mczerski/MysensorsDimmer/README.md

# MysensorsDimmer

Led dimmer board that can be controlled with local switches and remotely witch NRF24L01 RF module. It is based on the Arduino Pro Mini board and is intended to be used with MySensors library.
