mczerski/MysensorsDimmer/descriptions.odt

IN/LED1 | LED2 | LED3

12V GND PWM|12V GND PWM|12V GND PWM

LED4

12V GND PWM

LED5 | SWITCHES | OUT

12V GND PWM|S1 S2 S3 |GND 5V
