mczerski/MysensorsDimmer/MysensorsDimmer.brd

## EAGLE design MysensorsDimmer.brd (2017-07-23)

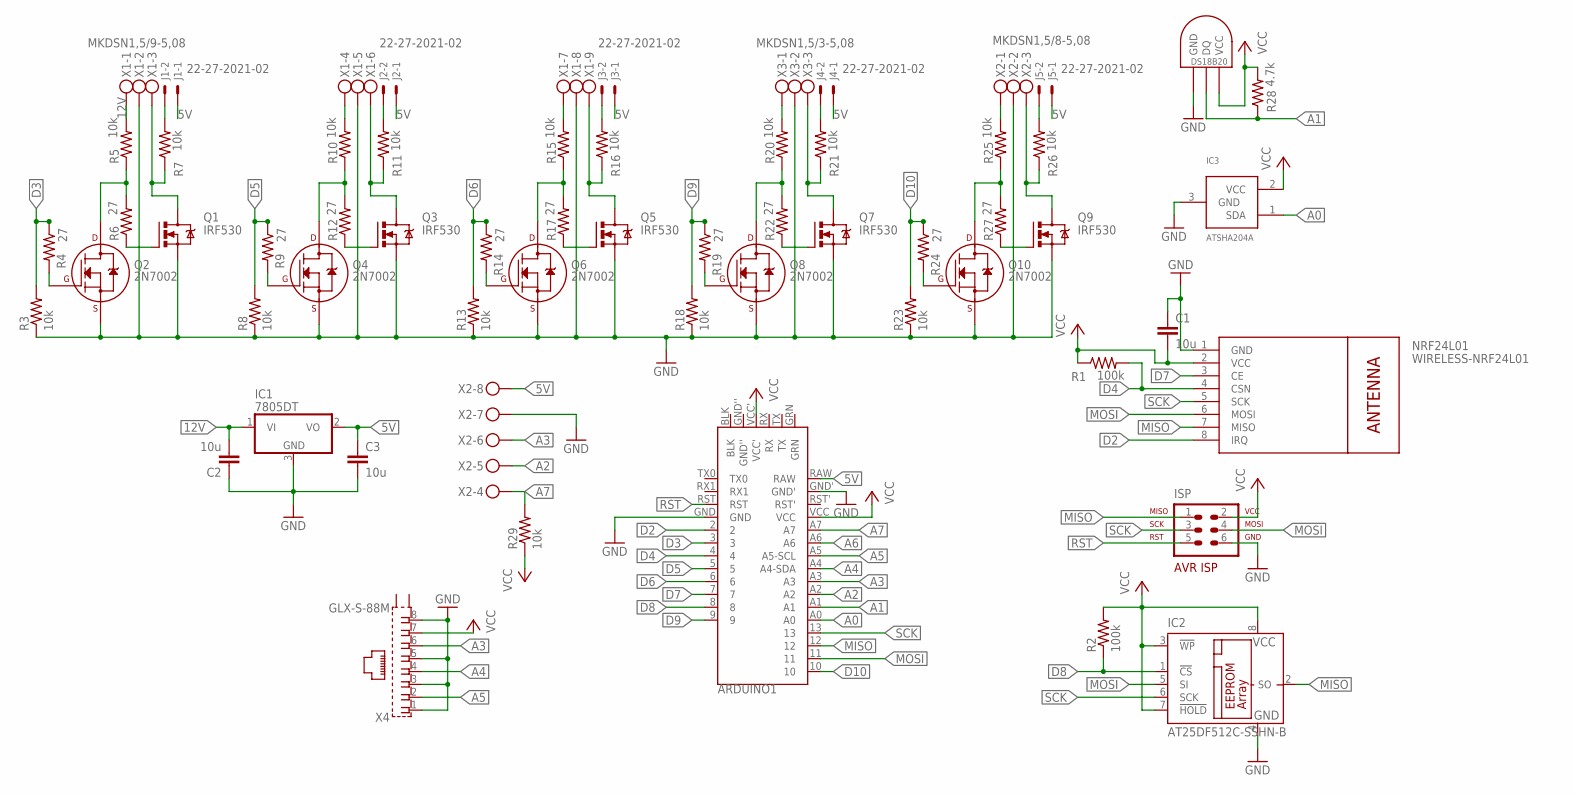
[picture p1: schematic MysensorsDimmer.sch]

Parts:
ARDUINO1: ARDUINO_PRO_MINI_V1
C1, C3: 10u; 0603-CAP
C2: 10u; 1206
IC1: 7805DT; TO252
IC2: AT25DF512C-SSHN-B; SO-08
IC3: ATSHA204A; SOT23
IC4: DS1820; µSOP8
ISP: N/M; AVR-ISP-6
J1, J2, J3, J4, J5: 22-27-2021-02; 6410-02
NRF24L01: WIRELESS-NRF24L01
Q1, Q3, Q5, Q7, Q9: IRF530; TO220BV
Q2, Q4, Q6, Q8, Q10: 2N7002; SOT-23
R1, R2: 100k; 0603-RES
R3, R5, R7, R8, R10, R11, R13, R15, R16, R18, R20, R21, R23, R25, R26, R29: 10k; 0603-RES
R4, R6, R9, R12, R14, R17, R19, R22, R24, R27: 27; 0603-RES
R28: 4.7k; 0603-RES
X1: MKDSN1,5/9-5,08
X2: MKDSN1,5/8-5,08
X3: MKDSN1,5/3-5,08
X4: GLX-S-88M

Connections:
5V: ARDUINO1.RAW, C3.1, IC1.2 (VO), J1.1, J2.1, J3.1, J4.1, J5.1, X2.8
12V: C2.2, IC1.1 (VI), R5.2, X1.1
A0: ARDUINO1.A0, IC3.1 (SDA)
A1: ARDUINO1.A1, IC4.1 (DQ), R28.1
A2: ARDUINO1.A2, X2.5
A3: ARDUINO1.A3, X2.6, X4.6
A4: ARDUINO1.A4 (A4-SDA), X4.4
A5: ARDUINO1.A5 (A5-SCL), X4.2
A6: ARDUINO1.A6
A7: ARDUINO1.A7, R29.2, X2.4
D2: ARDUINO1.2, NRF24L01.8 (IRQ)
D3: ARDUINO1.3, R3.2, R4.1
D4: ARDUINO1.4, NRF24L01.4 (CSN), R1.2
D5: ARDUINO1.5, R8.2, R9.1
D6: ARDUINO1.6, R13.2, R14.1
D7: ARDUINO1.7, NRF24L01.3 (CE)
D8: ARDUINO1.8, IC2.1 (!CS), R2.1
D9: ARDUINO1.9, R18.2, R19.1
D10: ARDUINO1.10, R23.2, R24.1
GND: ARDUINO1.GND, ARDUINO1.GND', C1.1, C2.1, C3.2, IC1.3 (GND), IC2.4 (GND), IC3.3 (GND), IC4.4 (GND), ISP.6, NRF24L01.1 (GND), Q1.S, Q2.2 (S), Q3.S, Q4.2 (S), Q5.S, Q6.2 (S), Q7.S, Q8.2 (S), Q9.S, Q10.2 (S), R3.1, R8.1, R13.1, R18.1, R23.1, X1.2, X1.5, X1.8, X2.2, X2.7, X3.2, X4.1, X4.3, X4.5, X4.8
MISO: ARDUINO1.12, IC2.2 (SO), ISP.1, NRF24L01.7 (MISO)
MOSI: ARDUINO1.11, IC2.5 (SI), ISP.4, NRF24L01.6 (MOSI)
unnamed: Q3.D, R11.1, X1.6
unnamed: Q1.G, R6.1
unnamed: Q4.1 (G), R9.2
unnamed: Q4.3 (D), R10.1, R12.2
unnamed: Q2.1 (G), R4.2
unnamed: Q3.G, R12.1
unnamed: J2.2, R11.2
unnamed: Q2.3 (D), R5.1, R6.2
unnamed: J1.2, R7.2
unnamed: Q5.D, R16.1, X1.9
unnamed: Q6.1 (G), R14.2
unnamed: Q6.3 (D), R15.1, R17.2
unnamed: Q5.G, R17.1
unnamed: J3.2, R16.2
unnamed: Q7.D, R21.1, X3.3
unnamed: Q8.1 (G), R19.2
unnamed: Q8.3 (D), R20.1, R22.2
unnamed: Q7.G, R22.1
unnamed: J4.2, R21.2
unnamed: Q9.D, R26.1, X2.3
unnamed: Q10.1 (G), R24.2
unnamed: Q1.D, R7.1, X1.3
unnamed: Q10.3 (D), R25.1, R27.2
unnamed: Q9.G, R27.1
unnamed: J5.2, R26.2
unnamed: R10.2, X1.4
unnamed: R15.2, X1.7
unnamed: R20.2, X3.1
unnamed: R25.2, X2.1
RST: ARDUINO1.RST, ISP.5
SCK: ARDUINO1.13, IC2.6 (SCK), ISP.3, NRF24L01.5 (SCK)
VCC: ARDUINO1.VCC, ARDUINO1.VCC', C1.2, IC2.3 (!WP), IC2.7 (!HOLD), IC2.8 (VCC), IC3.2 (VCC), IC4.8 (VCC), ISP.2, NRF24L01.2 (VCC), R1.1, R2.2, R28.2, R29.1, X4.7

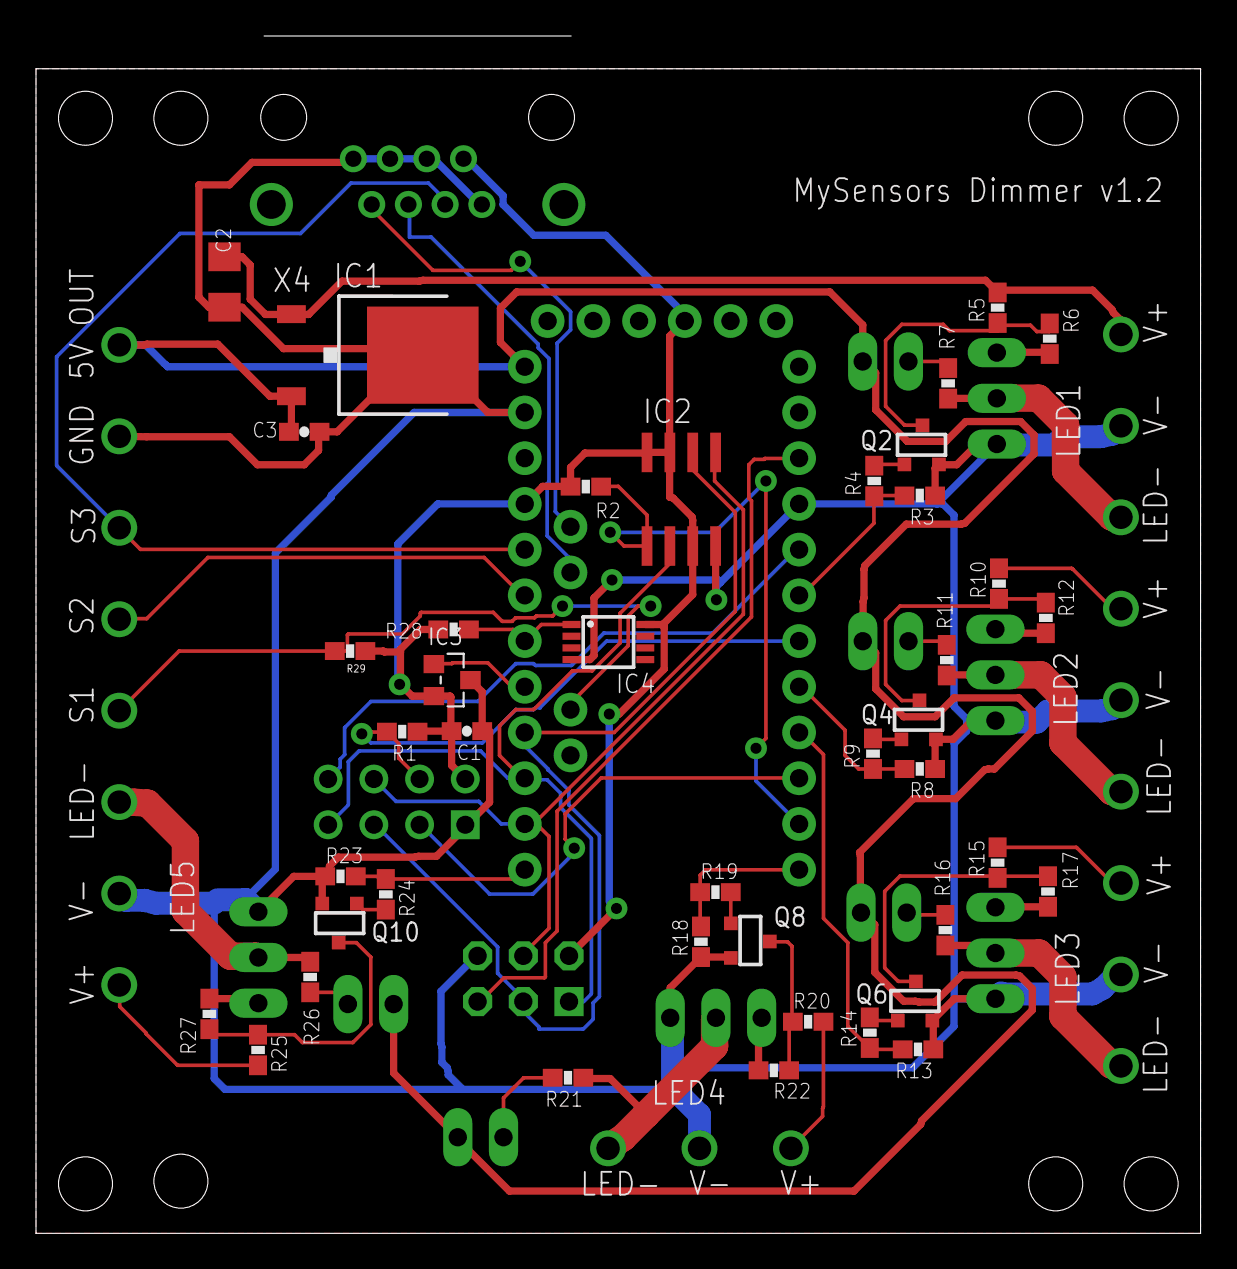
[picture p2: board MysensorsDimmer.brd from above]

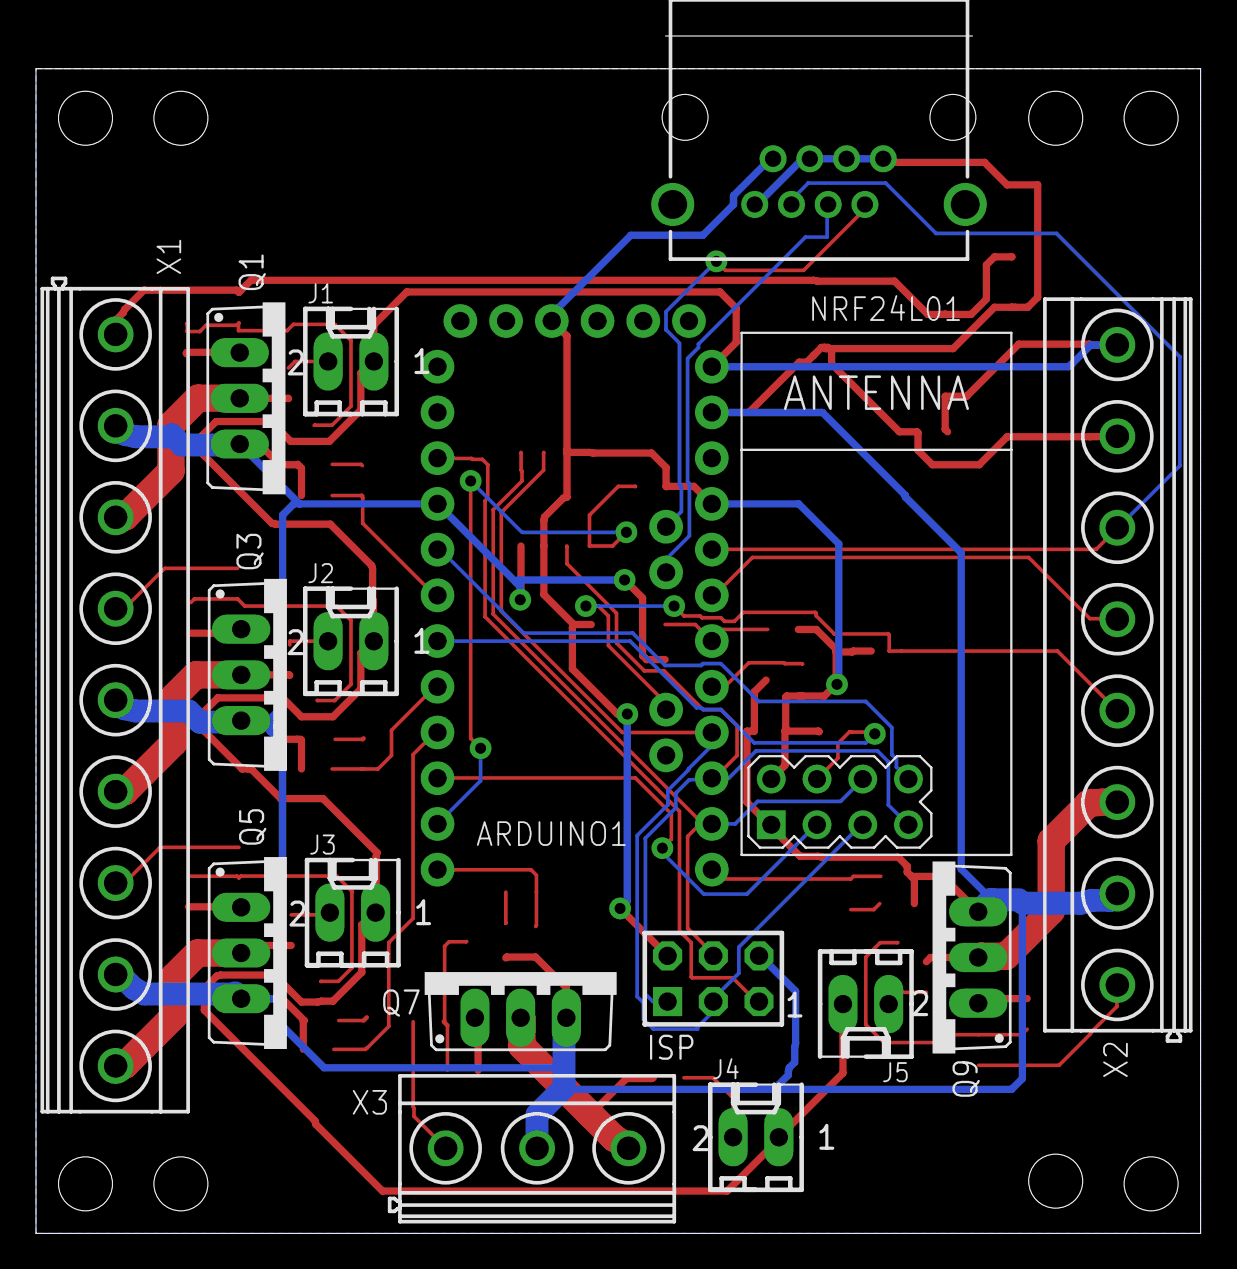
[picture p3: board MysensorsDimmer.brd from below]

Board: 2 copper layers, 64.7 x 66.5 mm, 58 parts (16 on the bottom side), 53 nets.
