mczerski/MysensorsDimmer/(commit log)

2017-06-05 initial version
    [MysensorsDimmer.brd, MysensorsDimmer.sch]
2017-06-05 corrected descriptions, names, etc.
    [MysensorsDimmer.brd, MysensorsDimmer.sch]
2017-06-05 adapted to SUPERTRONIC PP83N enclosure + corrected nrf module position in relation to screw connectors (they were overlaping)
    [MysensorsDimmer.brd]
2017-06-05 modifications after v1.0 version (see changelog.txt)
    [MysensorsDimmer.brd, MysensorsDimmer.sch]
2017-06-05 corrected descriptions and holes positions
    [MysensorsDimmer.brd]
2017-07-18 fix mounting hole position
    [MysensorsDimmer.brd]
2017-07-21 add i2c connection for apds 9930
    [MysensorsDimmer.brd, MysensorsDimmer.sch]
2017-07-23 version update
    [MysensorsDimmer.brd]
